WeiU/WriterV2.00-Circuit/量產測試報告/20191204/20191204-172727-962.jpg

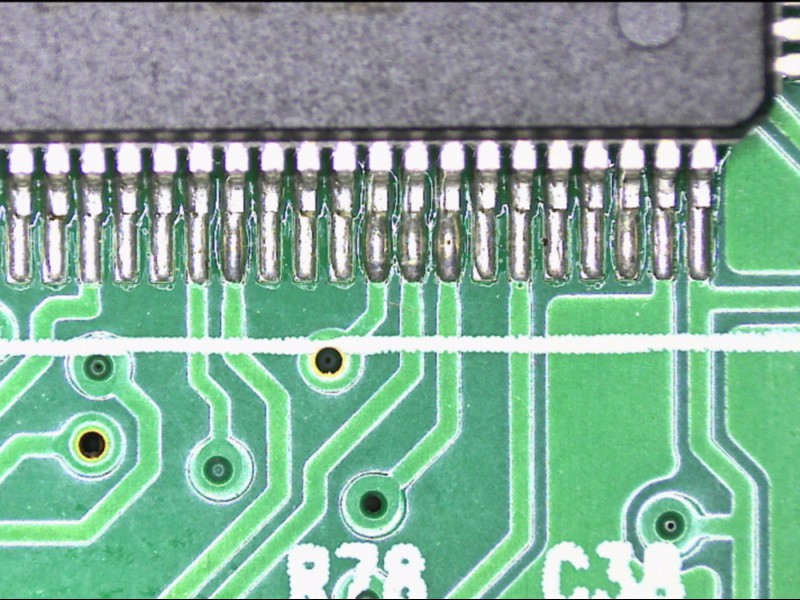
量產測試報告/20191204/20191204-172727-962.jpg
