WeiU/WriterV2.00-Circuit/量產測試報告/20191204/錯誤報告.docx

打件錯誤報告

1. D1打反

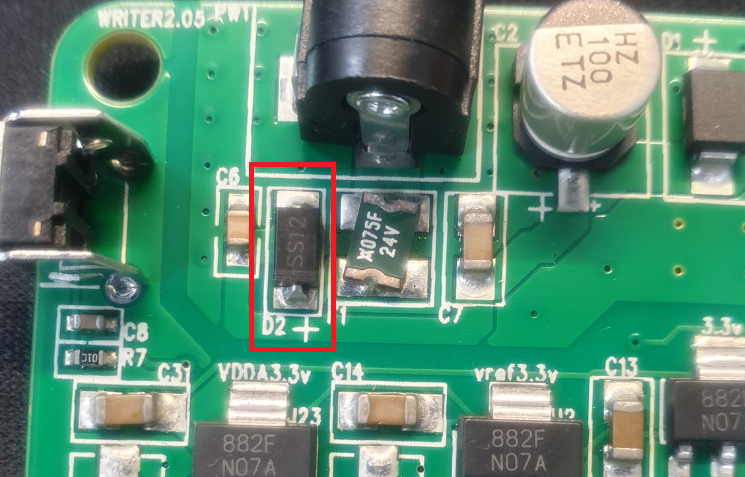
[picture p3: figure]

2. U18 空焊

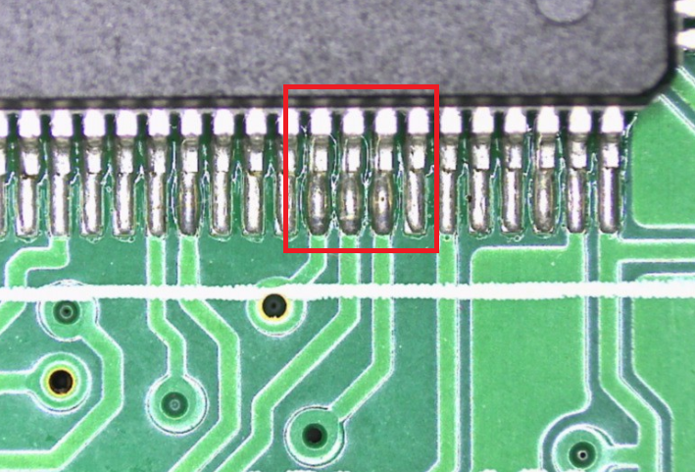
[picture p4: figure]
