WeiU/WriterV2.00-Circuit/量產測試報告/20191204/第一次打件缺料項目.png

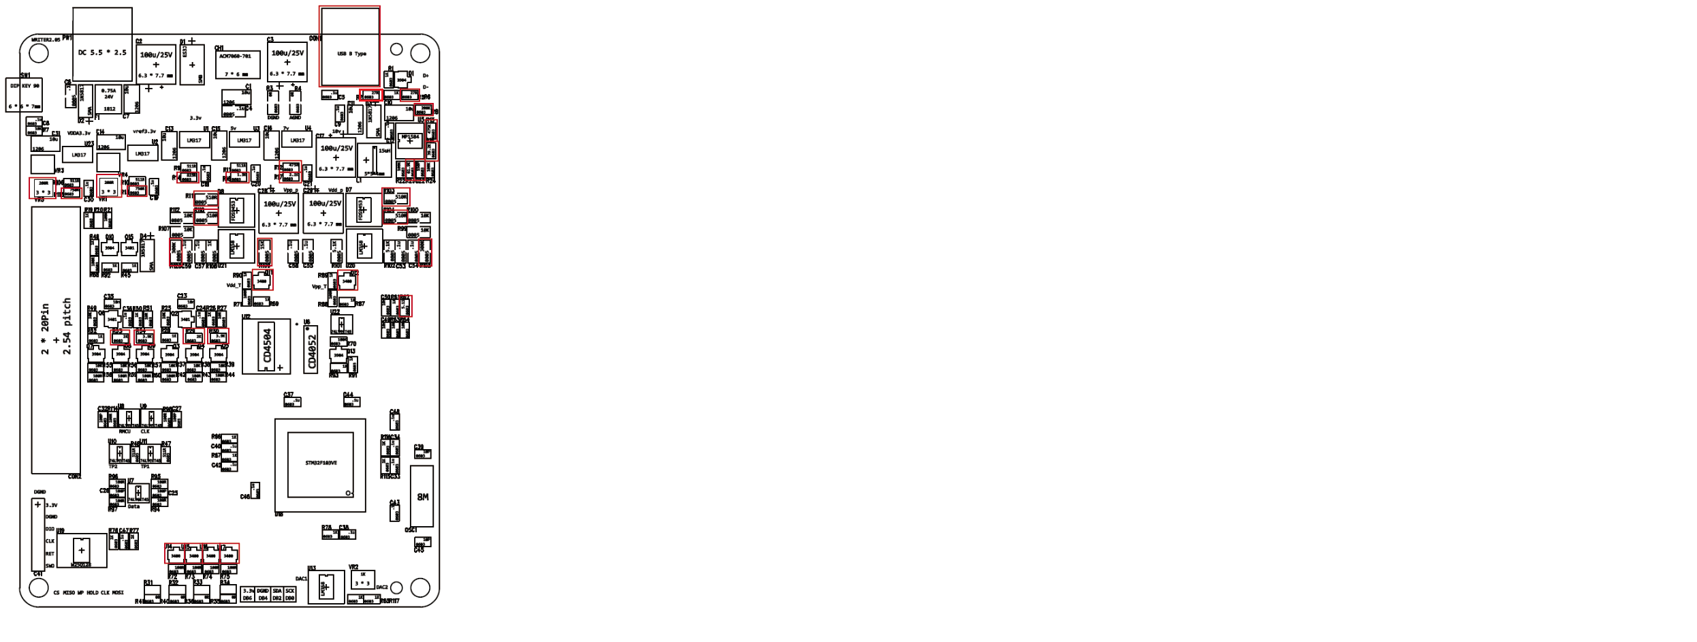
量產測試報告/20191204/第一次打件缺料項目.png
