WeiU/WriterV2.00-Circuit/ESWriter Top Bom.xlsx

Item | Qty | Reference | Part Name | PC | 淘寶網址
1 | 1 | CON2 | DIP7*2雙排排母(2.54 Pitch) | 0.42 | https://detail.tmall.com/item.htm?id=598475939200&cm_id=140105335569ed55e27b&abbucket=5&skuId=4335529918060
2 | 1 | CON3 | DIP20x2 排真母座(2.54 Pitch) | 0.9 | https://detail.tmall.com/item.htm?id=598475939200&cm_id=140105335569ed55e27b&abbucket=5&skuId=4335529918060
3 | 1 | CON4 | 40PIN IC插座 圆孔 | 1.2 | https://item.taobao.com/item.htm?id=44449054806&ns=1&abbucket=5 (https://item.taobao.com/item.htm?spm=a230r.1.14.45.1c4257b6KEyiCt&id=44449054806&ns=1&abbucket=5)
4 | 1 | CON5 | 欧式插座9001-3164(公) 90度灣针 | 6.5 | https://item.taobao.com/item.htm?id=19666299867&ns=1&abbucket=7 (https://item.taobao.com/item.htm?spm=a230r.1.14.140.3e0e7c13k6JNJt&id=19666299867&ns=1&abbucket=7)
5 | 2 | D1 D4 | LED3MM(紅) | 0.0228 | https://detail.tmall.com/item.htm?id=597689520247&ns=1&abbucket=5&skuId=4335872971592
6 | 1 | D2 | LED3MM(黃) | 0.0228 | https://detail.tmall.com/item.htm?id=597689520247&ns=1&abbucket=5&skuId=4335872971592
7 | 1 | D3 | LED3MM(綠) | 0.0228 | https://detail.tmall.com/item.htm?id=597689520247&ns=1&abbucket=5&skuId=4335872971592
8 | 1 | SW4 | PB86 | 2.6 | https://item.taobao.com/item.htm?id=521043615670&_u=t2dmg8j26111
9 | 3 | R2 R9 R22 | RES,0(0603) | 0.015
10 | 4 | R12 R15 R16 R18 | RES,100k(0603) | 0.03
11 | 8 | R3 R4 R5 R6 R8 R19 R20 R21 | RES,1K(0603) | 0.02
12 | 4 | R10 R11 R13 R17 | RES,330(0603) | 0.02
13 | 2 |  | M2*11 平頭六角銅柱 | 0.18 | https://detail.tmall.com/item.htm?id=36045995111&ns=1&abbucket=5&skuId=3539373165542
14 | 2 |  | 沉頭十字螺釘 M2*4 | 0.0382 | https://detail.tmall.com/item.htm?id=35045223371&cm_id=140105335569ed55e27b&abbucket=5&skuId=49645212407
15 | 1 |  | LCD1602液晶屏 LCM1602H 綠光 | 15 | http://tw.taobao.com/item/35517255666.htm
16 | 1 |  | 2.54间距 锁紧双列 测试座 40Pin | 20 | https://item.taobao.com/item.htm?id=5701275482&ns=1&abbucket=5 (https://item.taobao.com/item.htm?spm=a230r.1.14.64.2dcc1b2aySRckA&id=5701275482&ns=1&abbucket=5)
