WeiU/WriterV2.00-Circuit/ESWriter Master Bom.xlsx

Item | Qty | Reference | Part Name | Package | PC | 淘寶網址
1 | 5 | C2 C3 C17 C28 C29 | 100u/25V | 6.3*7.7mm | 0.59 | https://item.taobao.com/item.htm?id=583075528630&ns=1&abbucket=7 (https://item.taobao.com/item.htm?spm=a230r.1.14.9.69727e93Dl1K5Z&id=583075528630&ns=1&abbucket=7)
2 | 8 | C4 C6 C53 C54 C55 C57 C58 C59 | 0.1u | 0805 | 0.12 | https://item.taobao.com/item.htm?id=560809600869&ns=1&abbucket=5 (https://item.taobao.com/item.htm?spm=a230r.1.14.20.67ee5246x03aOb&id=560809600869&ns=1&abbucket=5)
3 | 22 | C5 C8 C9 C12 C18 C19 C20 C21 C24 C30 C33 C34 C36 C37 C38 C40 C42 C43 C44 C46 C47 C48 | 0.1u | 0603 | 0.09 | https://item.taobao.com/item.htm?spm=a1z10.3-c-s.w4002-21223910208.38.13236a4bXeB5rw&id=560886805480
4 | 4 | C25 C26 C27 C32 | 100P | 0603 | 0.02 | https://detail.tmall.com/item.htm?id=604015560445&cm_id=140105335569ed55e27b&abbucket=5
5 | 4 | C23 C35 C49 C50 | 103 | 0603 | 0.06 | https://item.taobao.com/item.htm?spm=a1z10.3-c-s.w4002-21223910208.33.24036a4b4JrxeO&id=560790060809
6 | 2 | C39 C45 | 10P | 0603 | 0.01 | https://item.taobao.com/item.htm?spm=a1z10.3-c-s.w4002-21223910208.13.9ff16a4bInvz8D&id=522554219575
7 | 9 | C1 C7 C10 C11 C13 C14 C15 C16 C31 | 10u | 1206 | 0.0644 | https://detail.tmall.com/item.htm?id=576652526273&rn=7179555e75083646177d89c970c86ad5&abbucket=3
8 | 1 | C22 | 150P | 0603 | 0.04 | https://detail.tmall.com/item.htm?id=21037679068&ns=1&abbucket=5&skuId=4374195410048
9 | 1 | U12 | CD4504 | SOP16 | 3 | https://item.taobao.com/item.htm?id=557062932566&ns=1&abbucket=5 (https://item.taobao.com/item.htm?spm=a230r.1.14.28.110b2ddeR1Tfr8&id=557062932566&ns=1&abbucket=5)
10 | 1 | U6 | CD4052 | SOP16 | 1 | https://item.taobao.com/item.htm?id=545029759711&ns=1&abbucket=5 (https://item.taobao.com/item.htm?spm=a230r.1.14.19.41d830cdIvSKJA&id=545029759711&ns=1&abbucket=5)
11 | 1 | CH1 | ACM7060-701 | 7mm x 6mm | 1.8 | https://item.taobao.com/item.htm?id=577746694774&ns=1&abbucket=7 (https://item.taobao.com/item.htm?spm=a230r.1.14.183.9481d673A7A3oA&id=577746694774&ns=1&abbucket=7)
12 | 1 | PW1 | DC 母座 | 5.5*2.5 | 0.12 | https://item.taobao.com/item.htm?id=571027512062&ns=1&abbucket=7 (https://item.taobao.com/item.htm?spm=a230r.1.14.85.34743135qBo6at&id=571027512062&ns=1&abbucket=7)
13 | 3 | D2 D3 D4 | 1N5817(SS12) | SMA | 0.044 | https://detail.tmall.com/item.htm?id=595874844082&ali_trackid=1_e9a9bb3eccec898086b40f45e3c757f4
14 | 1 | D1 | ES3J | SMB | 0.25 | https://item.taobao.com/item.htm?id=551060631627&ns=1&abbucket=7 (https://item.taobao.com/item.htm?spm=a230r.1.14.3.78615234Wq5TEK&id=551060631627&ns=1&abbucket=7)
15 | 1 | CON2 | 2*20Pin 雙排排母 | 2.54 Pitch | 0.36 | https://item.taobao.com/item.htm?spm=a1z10.3-c-s.w4002-21223910208.13.5a006a4bPvlYMr&id=522576768218
16 | 2 | D7 D8 | FDS9453 | SOP8 | 0.32 | https://item.taobao.com/item.htm?id=524609267894&ali_trackid=1_df666de1c905be4ec9090cf48bc8ca88
17 | 1 | F1 | 贴片自恢复保险丝 0.75A 24V | 1812 | 0.16 | https://item.taobao.com/item.htm?spm=2013.1.0.0.b46e26180wlRbu&id=560340918708
18 | 1 | L1 | CD54 15uH 150屏蔽电感 | 5*5*4mm | 0.299 | https://detail.tmall.com/item.htm?id=39076418936&ali_trackid=1_ad03c7bf66d2d37a38364114220d8313
19 | 3 | U13 U20 U21 | LM358 | SOIC-8 | 0.39 | https://item.taobao.com/item.htm?id=546962244121
20 | 5 | U1 U2 U3 U4 U23 | LM317 | SOT-223 | 2.2 | https://item.taobao.com/item.htm?spm=a1z10.3-c-s.w4002-21223910208.21.72d36a4blJYpq5&id=570061540044
21 | 1 | U5 | MP1584 | SOIC-8 | 3 | https://detail.tmall.com/item.htm?spm=a230r.1.14.23.46503643lhXSuG&id=600653084825&ns=1&abbucket=5
22 | 6 | U14 U15 U16 U17 Q11 Q12 | AO3400(NMOS) | SOT-23 | 0.08 | https://item.taobao.com/item.htm?spm=a1z10.3-c-s.w4002-21223910208.10.53a36a4b8fQgJu&id=522574089119
23 | 9 | Q1 Q3 Q4 Q5 Q7 Q8 Q9 Q10 Q13 | MMBT3904 (1AM) | SOT-23 | 0.8 | https://item.taobao.com/item.htm?spm=a1z10.3-c-s.w4002-21223910208.10.67036a4b9ZF6mR&id=585973820108
24 | 1 | OSC1 | 8M | 49SMD | 0.23 | https://item.taobao.com/item.htm?spm=a1z10.5-c-s.w4002-21223910190.34.5b374450LsWpGQ&id=522574065427
25 | 3 | Q2 Q6 Q15 | AO3401(PMOS) | SOT-23 | 0.08 | https://item.taobao.com/item.htm?spm=a1z10.5-c-s.w4002-21223910190.13.61764450cOrpVs&id=522554663865
26 | 14 | R3 R4 R35 R36 R40 R41 R79 R80 R81 R82 R83 R84 R85 R86 | 0Ω | 0603
27 | 2 | R27 R51 | 10Ω | 0603
28 | 19 | R42 R43 R44 R58 R59 R60 R68 R71 R72 R73 R74 R75 R88 R94 R95 R96 R97 R98 R114 | 100Ω | 0603
29 | 4 | R21 R22 R24 R70 | 100KΩ | 0603
30 | 4 | R99 R100 R107 R112 | 10KΩ | 0805
31 | 10 | R25 R37 R38 R39 R49 R55 R56 R57 R63 R64 | 10KΩ | 0603
32 | 1 | R16 | 1.5KΩ | 0603
33 | 1 | R109 | 15KΩ | 0805
34 | 1 | R108 | 1KΩ | 0805
35 | 26 | R1 R5 R19 R26 R28 R45 R46 R50 R52 R61 R65 R66 R67 R69 R76 R77 R78 R87 R89 R90 R91 R92 R93 R115 R116 R117 | 1KΩ | 0603
36 | 1 | R17 | 2.2KΩ | 0603
37 | 1 | R8 | 200KΩ | 0603
38 | 2 | R2 R6 | 27Ω | 0603
39 | 2 | R29 R53 | 2KΩ | 0603
40 | 2 | R30 R54 | 3.9KΩ | 0603
41 | 2 | R105 R120 | 300KΩ | 0805
42 | 1 | R18 | 39.2KΩ | 0603
43 | 1 | R13 | 475KΩ | 0603
44 | 1 | R12 | 475Ω | 0603
45 | 2 | R101 R102 | 5.1KΩ | 0805
46 | 4 | R103 R104 R110 R111 | 510Ω | 0805
47 | 6 | R9 R10 R11 R47 R48 R106 | 511Ω | 0603
48 | 1 | R23 | 61.9KΩ | 0603
49 | 1 | R62 | 5.11KΩ | 0603
50 | 2 | R15 R113 | 750Ω | 0603
51 | 1 | R14 | 825Ω | 0603
52 | 6 | U7 U8 U9 U10 U11 U22 | SN74LVC1T45DBVR | DBV | 0.85 | https://item.taobao.com/item.htm?id=564992826603&ns=1&abbucket=7 (https://item.taobao.com/item.htm?spm=a230r.1.14.4.4b251b6enJhKEr&id=564992826603&ns=1&abbucket=7)
53 | 1 | U18 | STM32F103VE | LQFP100
54 | 1 | SW1 | 卧式插件90°DIP按键开关 | 6*6*7 | 0.09 | https://item.taobao.com/item.htm?id=580052351439&ns=1&abbucket=5 (https://item.taobao.com/item.htm?spm=a230r.1.14.29.669872e4kW9ts7&id=580052351439&ns=1&abbucket=5)
55 | 1 | CON1 | USB B TYPE | B TYPE
56 | 1 | VR2 | 1K VR | 3*3 | 0.12 | https://item.taobao.com/item.htm?spm=a21wu.12321156-tw.0.0.41007e78aAgAOd&id=538937741613
57 | 2 | VR1 VR5 | 200 VR | 3*3 | 0.12 | https://item.taobao.com/item.htm?spm=a1z10.3-c.w4002-13569356402.39.215d7003YFSgf5&id=538973332546
58 | 1 | U19 | W25Q128JVSSIQ | SOIC-8 208-mil | 2.54 | https://item.taobao.com/item.htm?id=580344507211&ns=1&abbucket=7 (https://item.taobao.com/item.htm?spm=a230r.1.14.29.f8cb3f39ZjIo0T&id=580344507211&ns=1&abbucket=7)
59 | 2 |  | M2*11 平頭六角銅柱
60 | 4 |  | 沉頭十字螺釘 M2*4
61 |  |  | 华硕PA-1650-66 78 93 02笔记本电脑充电源适配器线19V 3.42A电源 | 5.5*2.5 | 24.8 | https://item.taobao.com/item.htm?id=564465950425&ns=1&abbucket=5 (https://item.taobao.com/item.htm?spm=a230r.1.14.4.3f237629UVhy6X&id=564465950425&ns=1&abbucket=5)
