WeiU/WriterV2.00-Circuit/ESWriter Tran Bom.xlsx

Item | Qty | Reference | Part Name | PC | 淘寶網址
1 | 1 | CON1 | 欧式插座9001-3164(母) 180度 | 6.5(一組) | https://item.taobao.com/item.htm?id=19666299867&ns=1&abbucket=7 (https://item.taobao.com/item.htm?spm=a230r.1.14.140.3e0e7c13k6JNJt&id=19666299867&ns=1&abbucket=7)
