WeiU/WriterV2.00-Circuit/Master_Botton 元件位址.pdf

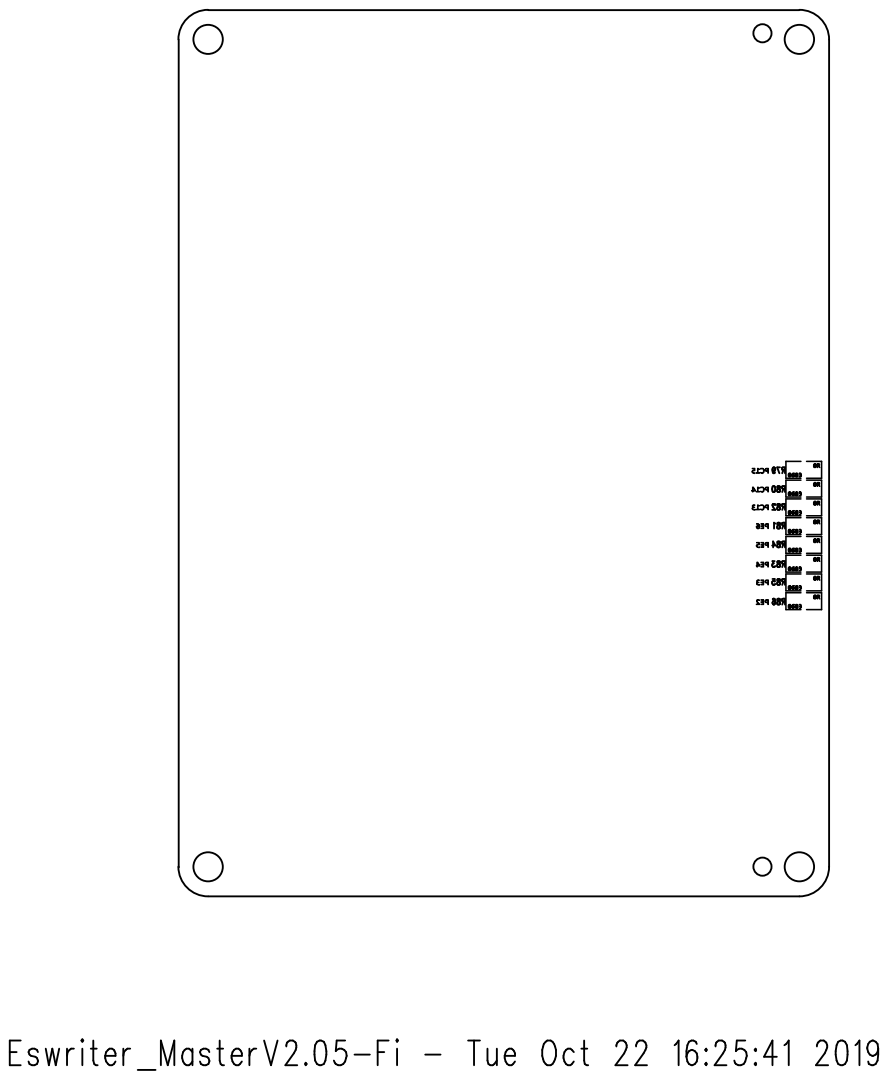
[picture p14: page 1]
