WeiU/WriterV2.00-Circuit/Master_Top 元件位址.pdf

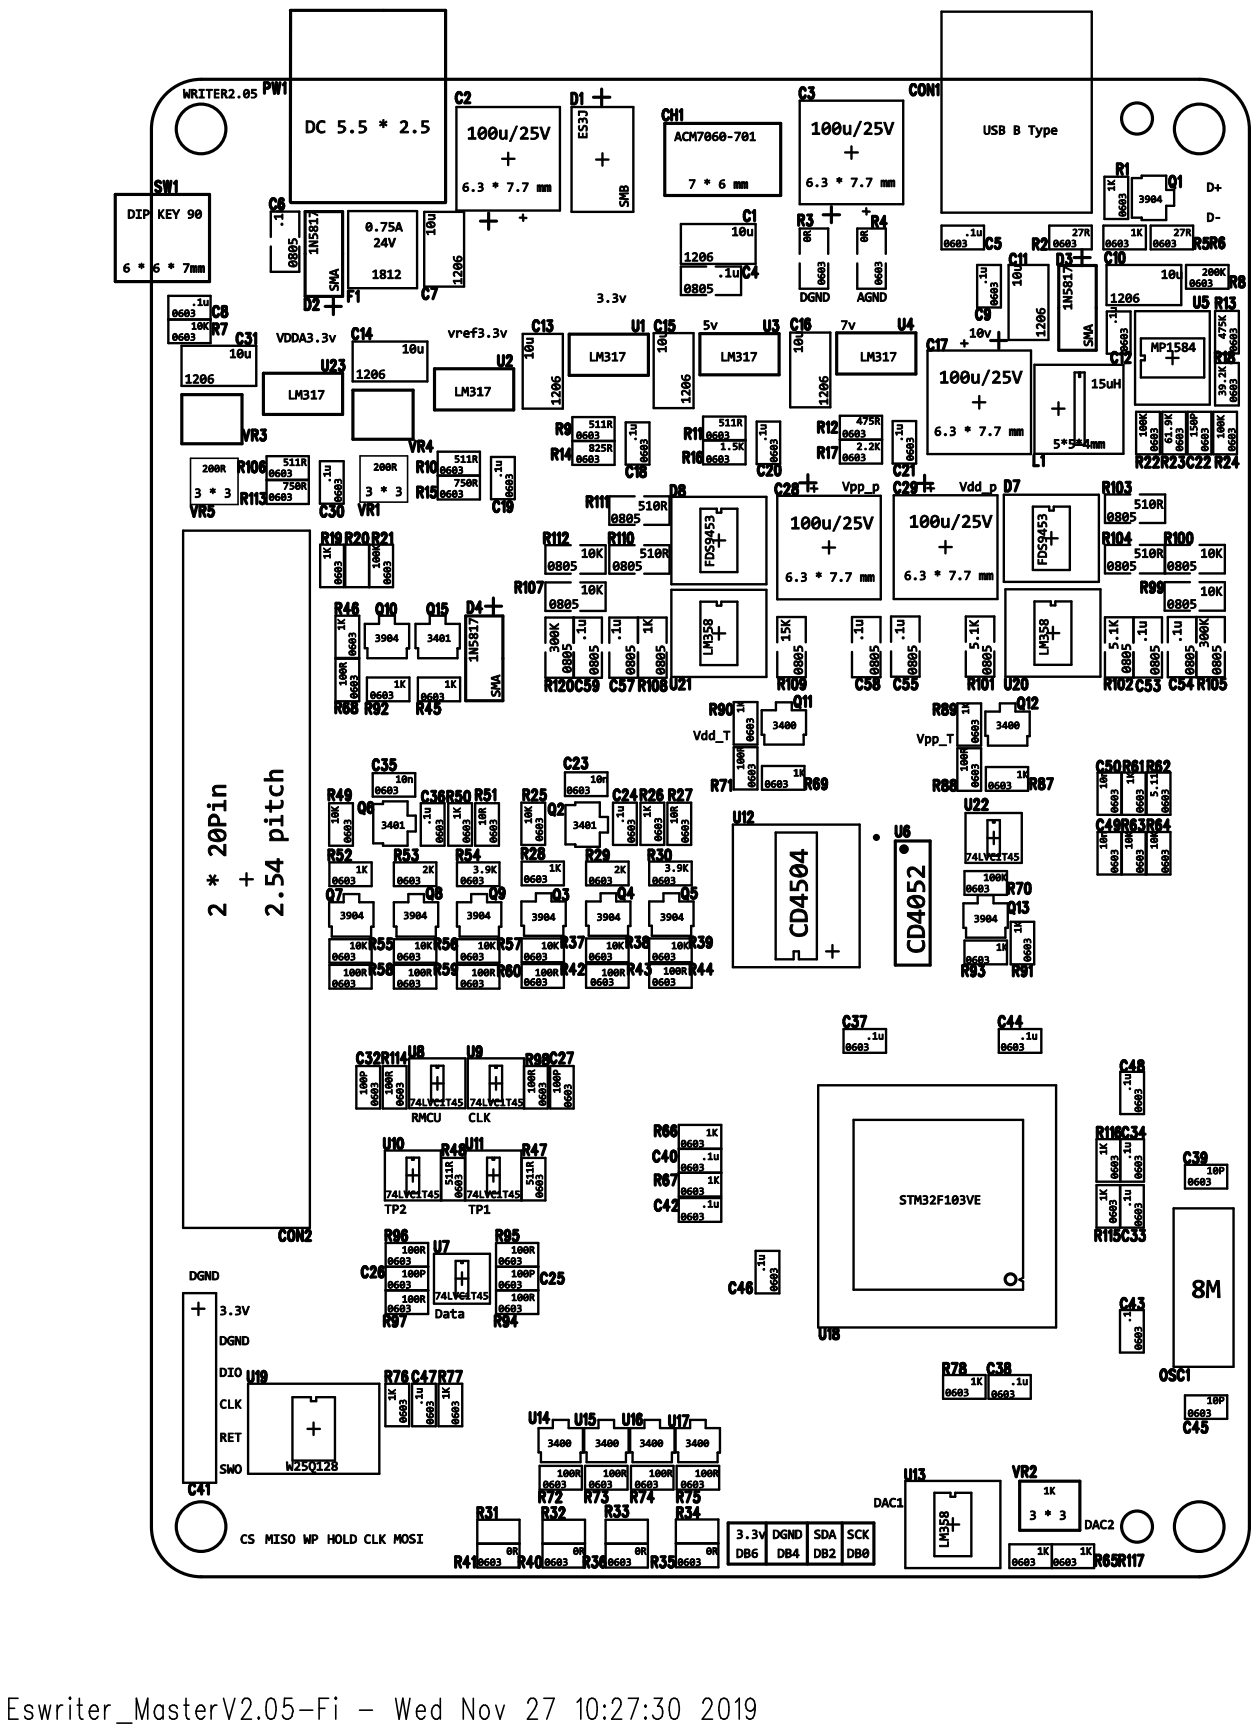
[picture p15: page 1]
