WeiU/WriterV2.00-Circuit/Mass/Master 元件標示.pdf

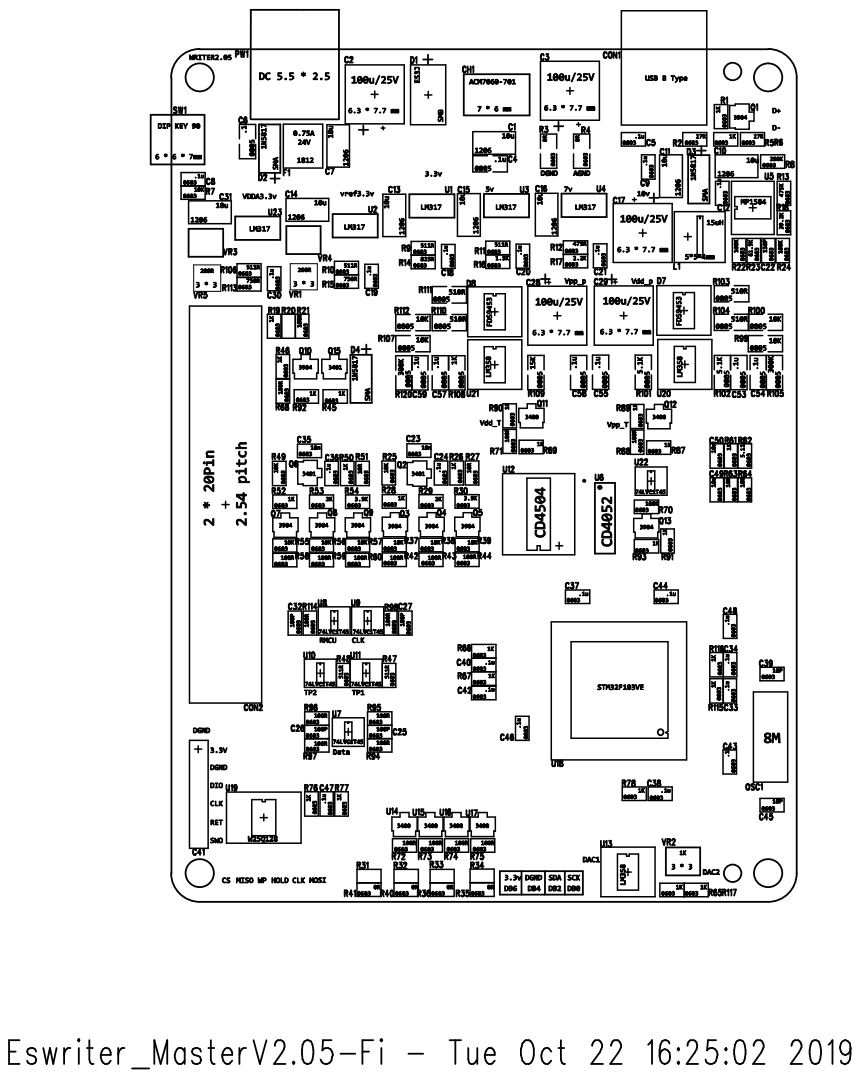
[picture p16: page 1]
