WeiU/WriterV2.00-Circuit/(list of files, drawings)

Other design files:
Eswriter_MasterV2.05-Final_1 - Label.pcb
Mass/master/Eswriter_MasterV2.05-Final_1.pcb
Mass/top/Eswriter_TopV2.01.pcb
Mass/tran/Eswriter_tranV2.01-No3.pcb
Mass/tran/Eswriter_tranV2.01-No4.pcb
Mass/tran/Eswriter_tranV2.01-No5.pcb
Mass/tran/Eswriter_tranV2.01-No6.pcb
Mass/tran/Eswriter_tranV2.01-No7.pcb
Mass/tran/Eswriter_tranV2.01-No8.pcb
Mass/tran/Eswriter_tranV2.01-No9.pcb
Mass/tran/Eswriter_tranV2.01-No10.pcb
Mass/tran/Eswriter_tranV2.01-No11.pcb
Mass/tran/Eswriter_tranV2.01-No12.pcb
Mass/tran/Eswriter_tranV2.01-No13.pcb
Mass/tran/Eswriter_tranV2.01_Empty.pcb
Mass/tran/Eswriter_tranV2.01_No0.pcb
Mass/tran/Eswriter_tranV2.01_No1.pcb
Mass/tran/Eswriter_tranV2.01_No2.pcb
PCB/Eswriter_MasterV2.04-8.pcb
PCB/Eswriter_MasterV2.05-1.pcb
PCB/Eswriter_MasterV2.05-2.pcb
PCB/Eswriter_MasterV2.05-3.pcb
PCB/Eswriter_MasterV2.05-4.pcb
PCB/Eswriter_MasterV2.05-5.pcb
PCB/Eswriter_MasterV2.05-6.pcb
PCB/Eswriter_MasterV2.05-7.pcb
PCB/Eswriter_MasterV2.05-8.pcb
PCB/Eswriter_MasterV2.05-9.pcb
PCB/Eswriter_MasterV2.05-10.pcb
PCB/Eswriter_MasterV2.05-11.pcb
PCB/Eswriter_MasterV2.05-12.pcb
PCB/Eswriter_MasterV2.05-13.pcb
PCB/Eswriter_MasterV2.05-Final.pcb
PCB/Eswriter_MasterV2.05-Final_1.pcb
PCB/Eswriter_MasterV2.05.pcb
PCB/Eswriter_TopV2.01.pcb
PCB/Eswriter_tranV2.01-No3.pcb
PCB/Eswriter_tranV2.01-No4.pcb
PCB/Eswriter_tranV2.01-No5.pcb
PCB/Eswriter_tranV2.01-No6.pcb
PCB/Eswriter_tranV2.01-No7.pcb
PCB/Eswriter_tranV2.01-No8.pcb
PCB/Eswriter_tranV2.01-No9.pcb
PCB/Eswriter_tranV2.01-No10.pcb
PCB/Eswriter_tranV2.01-No11.pcb
PCB/Eswriter_tranV2.01-No12.pcb
PCB/Eswriter_tranV2.01-No13.pcb
PCB/Eswriter_tranV2.01-NoBasis.pcb
PCB/Eswriter_tranV2.01.pcb
PCB/Eswriter_tranV2.01_No0.pcb
PCB/Eswriter_tranV2.01_No1.pcb
PCB/Eswriter_tranV2.01_No2.pcb
