WeiU/WriterV2.00-Circuit/量產測試報告/20191204/20191204_114224.jpg

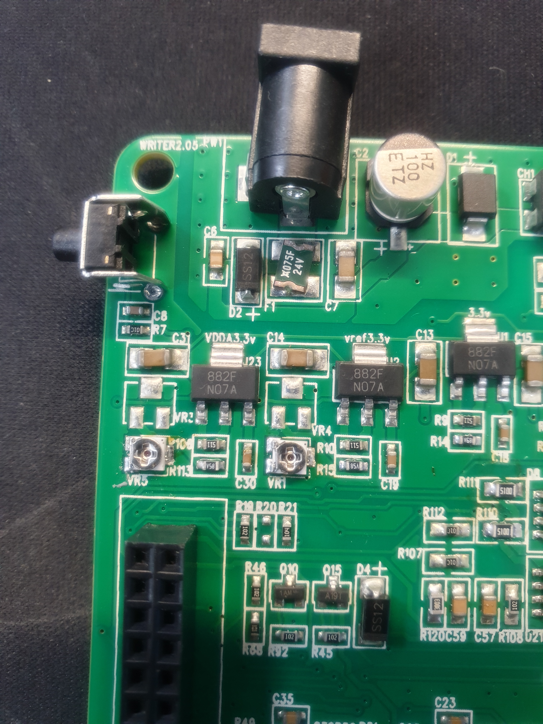
量產測試報告/20191204/20191204_114224.jpg
